shannon-greenlight/KiCAD/README.md

# Greenface KiCAD Libraries
The Greenface KiCAD libraries are required to use KiCAD with the Greenface designs.
KiCAD 8.0 or later is required.
* Place everything in a new folder named eg. GreenfaceKiCAD.
* For schematics, create a Project Specific Library eg. C:\Users\bill\Documents\GreenfaceKiCAD\greenface-symbols\greenface-symbols.kicad_sym
* Give this Library the Nickname: greenface
* For PCB, create a Project Specific Library eg. C:\Users\bill\Documents\GreenfaceKiCAD\panel.pretty
* Give this Library the Nickname: greenface
* For 3d Parts, create a Path called GREENFACE_KICAD_DIR with the value eg. C:\Users\bill\Documents\GreenfaceKiCAD
