shannon-greenlight/KiCAD/3d_Models/Sifam_Knob_Large_Short_Unskirted.step

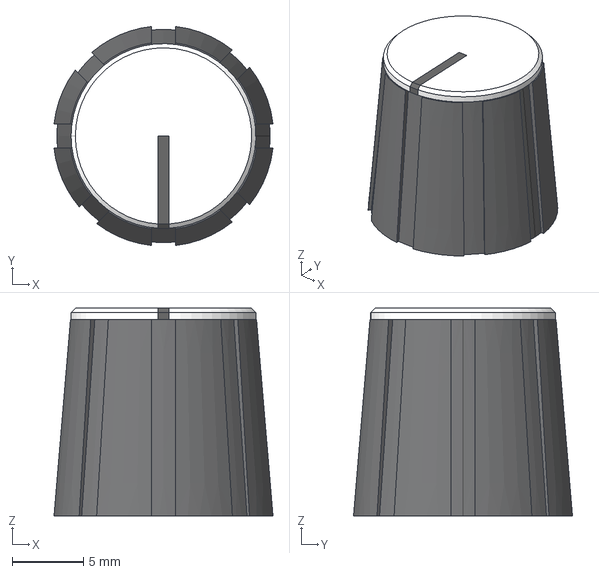
[picture p1: CAD file, 2024-02-22]
3d_Models/Sifam_Knob_Large_Short_Unskirted.step
15.4 x 15.4 x 14.6 mm
