shannon-greenlight/KiCAD/3d_Models/FreeCAD/Sifam_Knob_Parameterised.FCStd

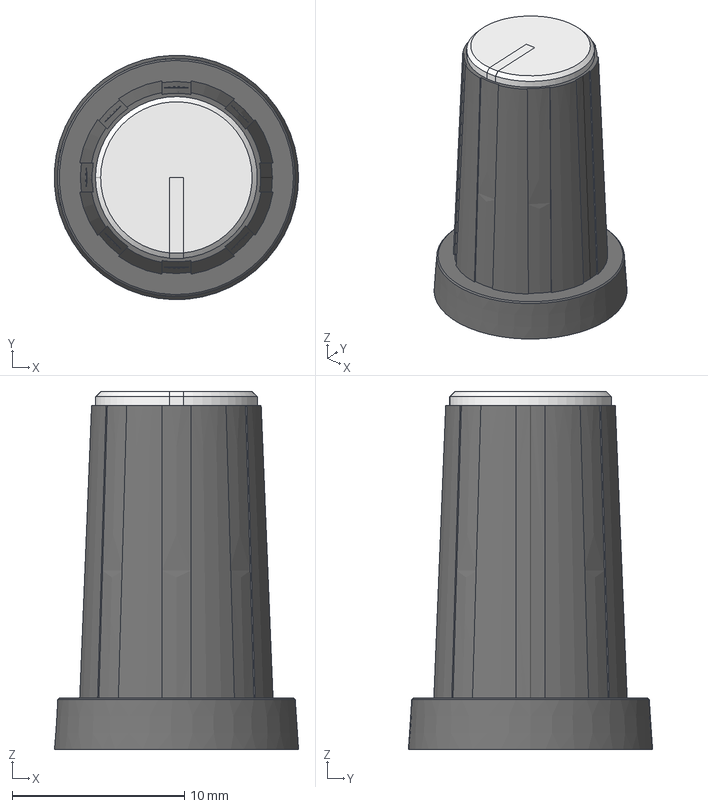
[picture p2: CAD file, 2024-02-22]
3d_Models/FreeCAD/Sifam_Knob_Parameterised.FCStd
14.2 x 14.2 x 20.8 mm
White_Cap_Chamfered
Black_Marker_Chamfered
Base
Ridged_Body
