shannon-greenlight/KiCAD/3d_Models/PTA4543-2010CPB103--3DModel-STEP-269445.STEP

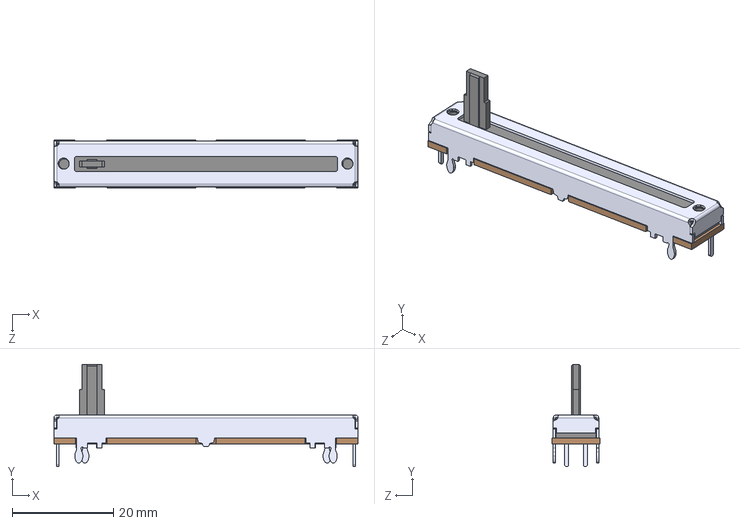
[picture p3: CAD file, 2024-02-22]
3d_Models/PTA4543-2010CPB103--3DModel-STEP-269445.STEP
60.0 x 20.2 x 9.40 mm
