shannon-greenlight/KiCAD/3d_Models/evqq2-bfkpuy-03w_.step

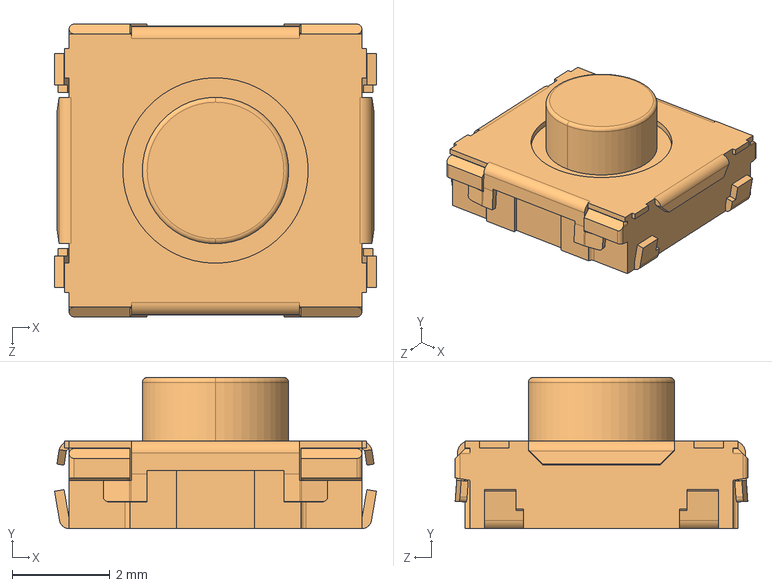
[picture p4: CAD file, 2024-02-22]
3d_Models/evqq2-bfkpuy-03w_.step
6.60 x 3.10 x 6.00 mm
