shannon-greenlight/KiCAD/3d_Models/FreeCAD/bu/knob.FCStd

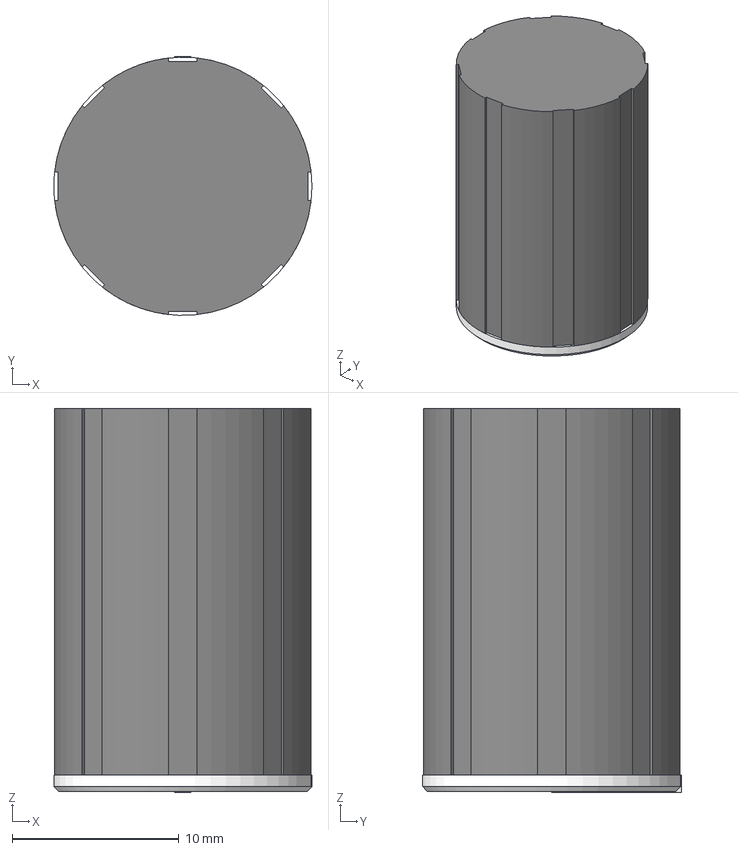
[picture p5: CAD file, 2024-02-22]
3d_Models/FreeCAD/bu/knob.FCStd
15.5 x 15.5 x 23.1 mm
Knob_Body
