shannon-greenlight/KiCAD/3d_Models/FreeCAD/bu/Sifam_Knob_Large_Tall_Unskirted.FCStd

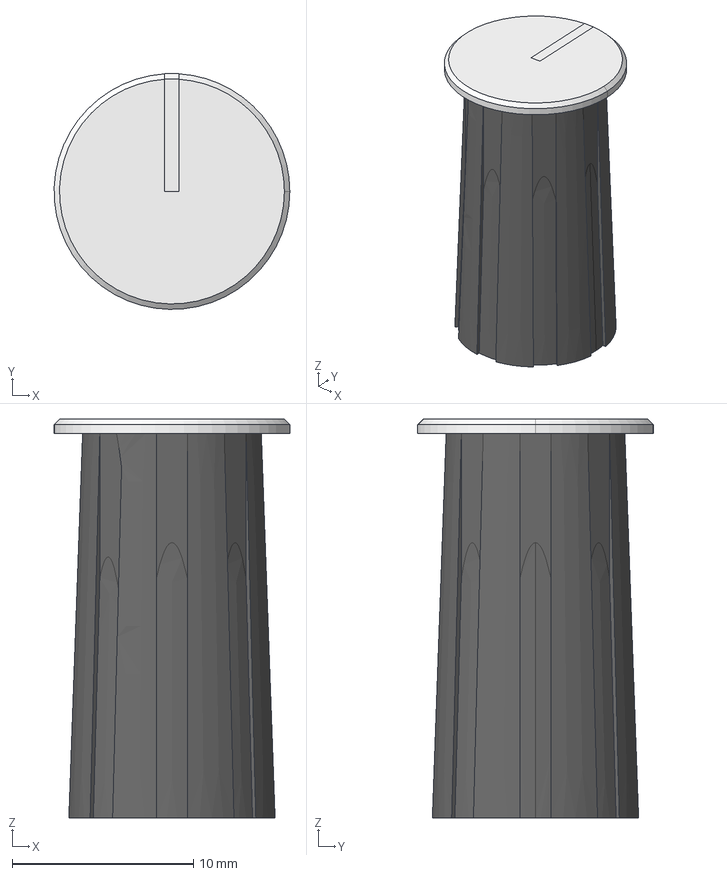
[picture p6: CAD file, 2024-02-22]
3d_Models/FreeCAD/bu/Sifam_Knob_Large_Tall_Unskirted.FCStd
13.0 x 13.0 x 22.0 mm
White_Cap_Chamfered
Black_Marker_Chamfered
Knob_Body_Ridged
