shannon-greenlight/KiCAD/3d_Models/RJ45 x 1.step

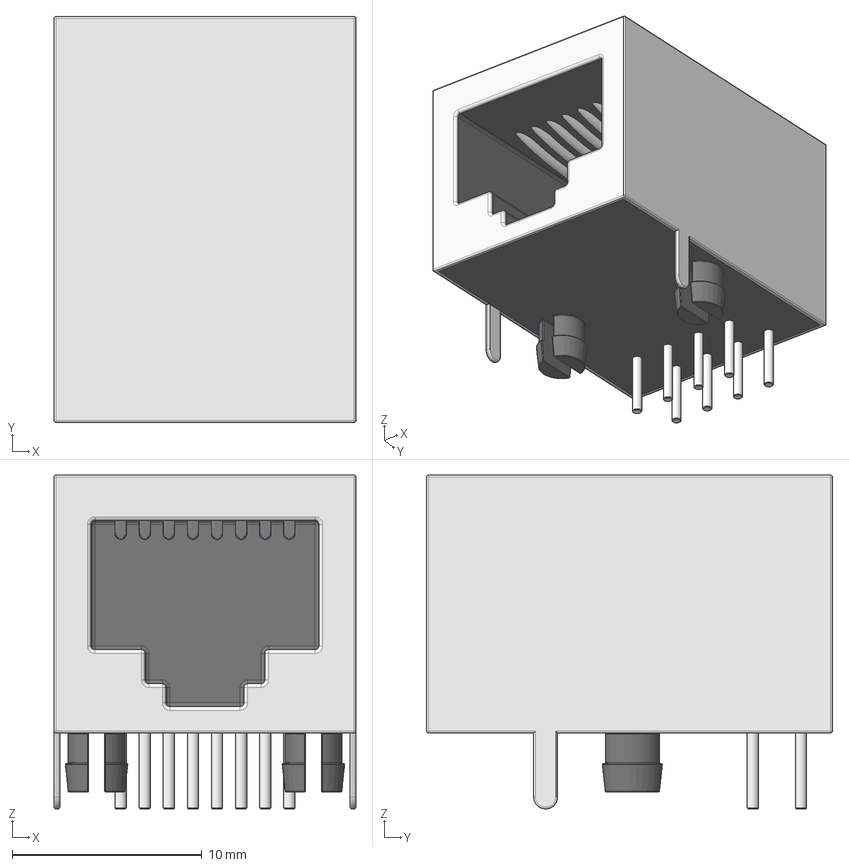
[picture p7: CAD file, 2024-02-22]
3d_Models/RJ45 x 1.step
15.9 x 21.4 x 17.6 mm
