shannon-greenlight/KiCAD/3d_Models/ALPHA-RD901F-40.step

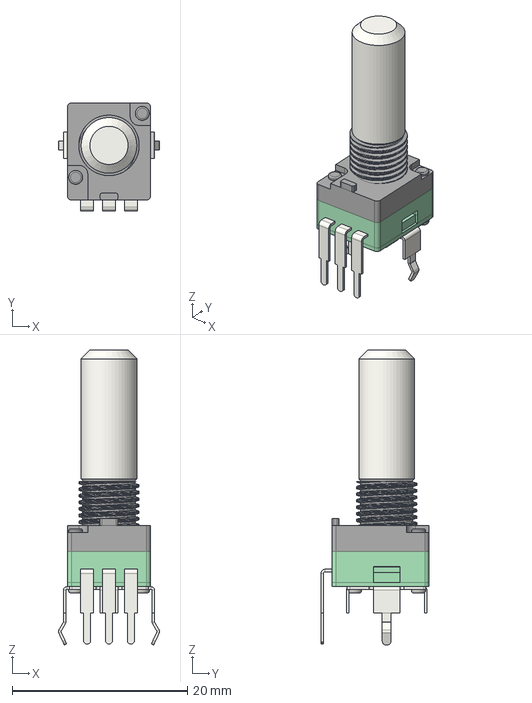
[picture p8: CAD file, 2024-02-22]
3d_Models/ALPHA-RD901F-40.step
11.5 x 12.4 x 33.6 mm
