shannon-greenlight/KiCAD/3d_Models/FreeCAD/bu/Sifam_Knob.FCStd

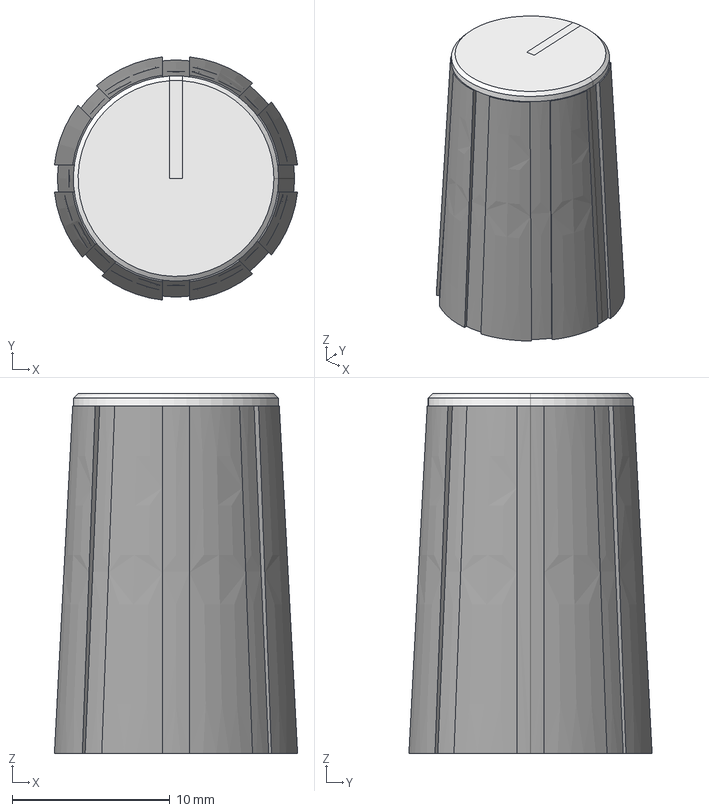
[picture p9: CAD file, 2024-02-22]
3d_Models/FreeCAD/bu/Sifam_Knob.FCStd
15.4 x 15.4 x 22.8 mm
Knob_Body_Ridged
White_Cap_Chamfered
Black_Marker_Chamfered
