shannon-greenlight/KiCAD/3d_Models/DX07S024WJ3R400--3DModel-STEP-56544.STEP

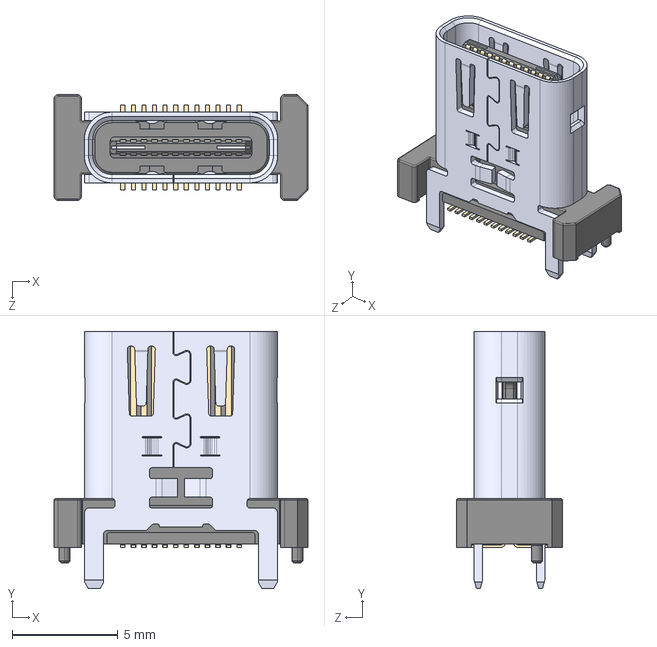
[picture p10: CAD file, 2024-02-22]
3d_Models/DX07S024WJ3R400--3DModel-STEP-56544.STEP
12.0 x 12.2 x 5.00 mm
