shannon-greenlight/KiCAD/3d_Models/smdcrystal.STEP

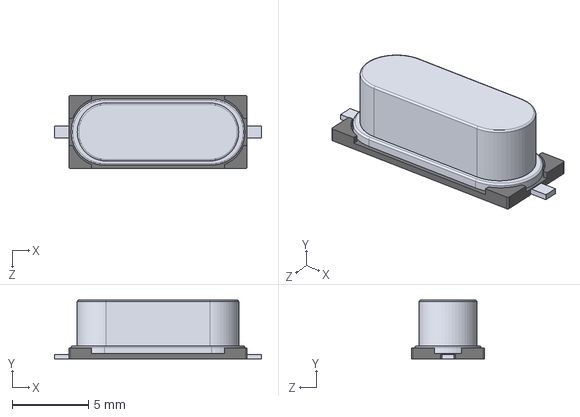
[picture p11: CAD file, 2024-02-22]
3d_Models/smdcrystal.STEP
13.6 x 3.85 x 4.80 mm
kalip
kristal
