shannon-greenlight/KiCAD/3d_Models/PJ301M-12 Thonkiconn v0.2.step

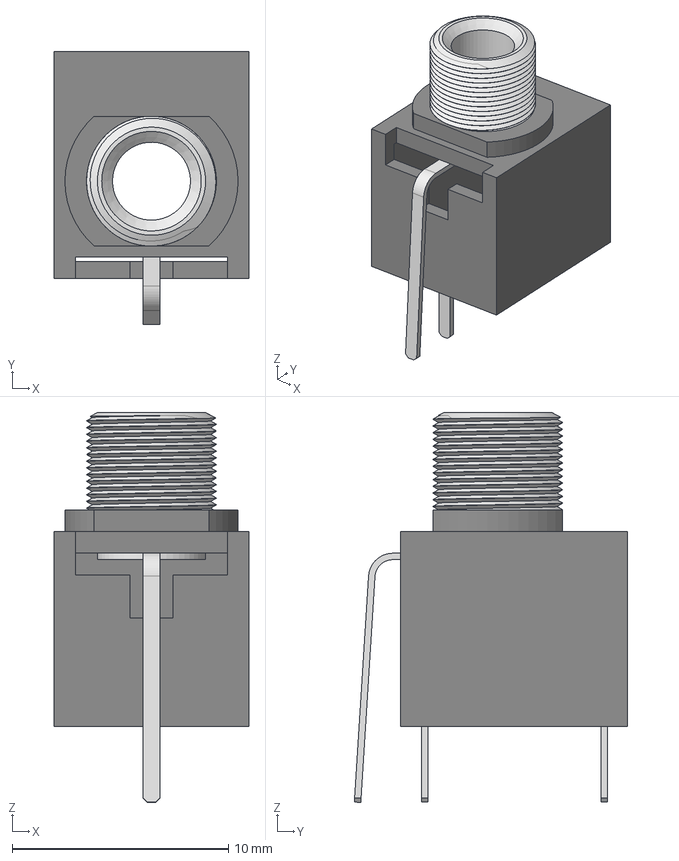
[picture p12: CAD file, 2024-02-22]
3d_Models/PJ301M-12 Thonkiconn v0.2.step
9.00 x 12.6 x 18.0 mm
