shannon-greenlight/KiCAD/3d_Models/100DP3T1B1M2QEH.step

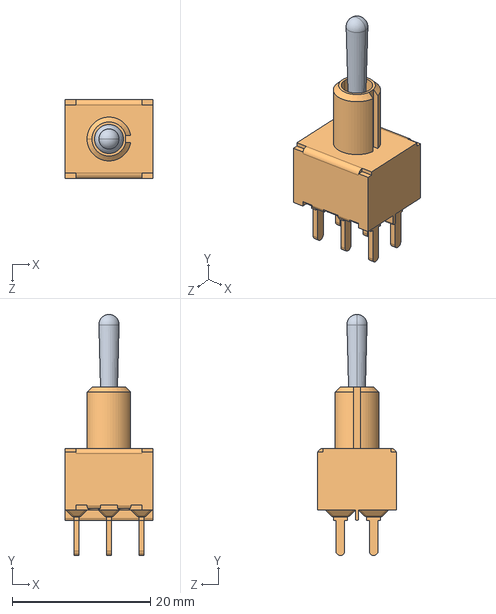
[picture p13: CAD file, 2024-02-22]
3d_Models/100DP3T1B1M2QEH.step
12.7 x 34.9 x 11.4 mm
