shannon-greenlight/KiCAD/3d_Models/Tall_Trimmer_Pot.step

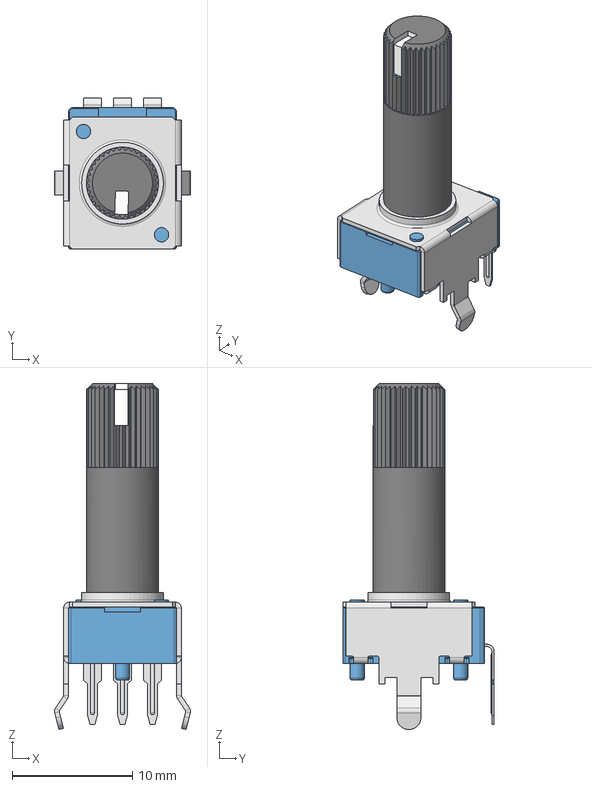
[picture p14: CAD file, 2024-02-22]
3d_Models/Tall_Trimmer_Pot.step
11.3 x 12.6 x 28.8 mm
