shannon-greenlight/KiCAD/3d_Models/PJ366ST.step

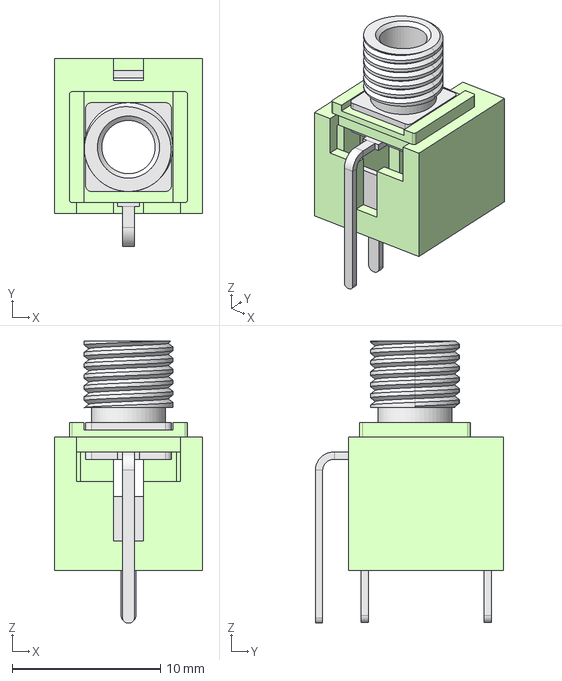
[picture p15: CAD file, 2024-02-22]
3d_Models/PJ366ST.step
10.0 x 12.7 x 19.1 mm
