shannon-greenlight/KiCAD/3d_Models/RJ45_Amphemol_RJHSE3080_c.step

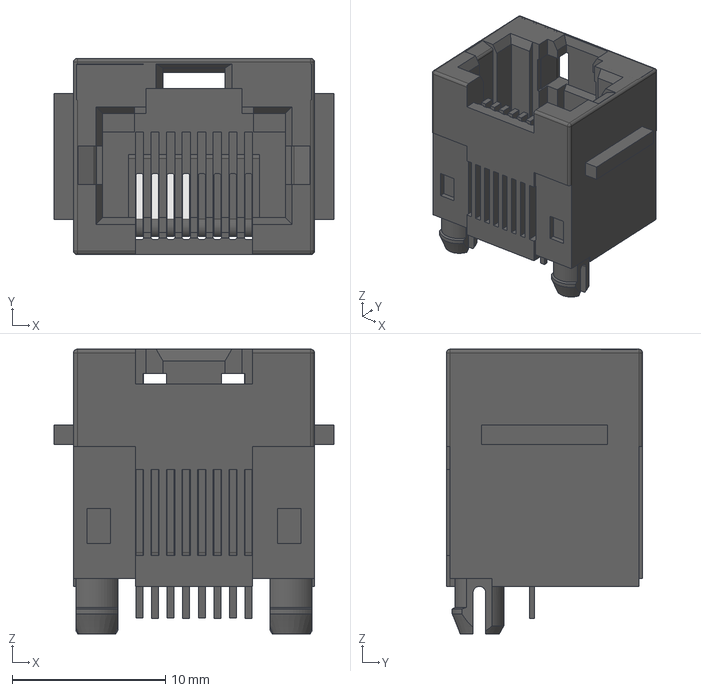
[picture p16: CAD file, 2024-02-22]
3d_Models/RJ45_Amphemol_RJHSE3080_c.step
18.3 x 12.8 x 18.6 mm
