shannon-greenlight/KiCAD/3d_Models/Toggle Switch Daily Well 1AS1T2B4M2QE.STEP

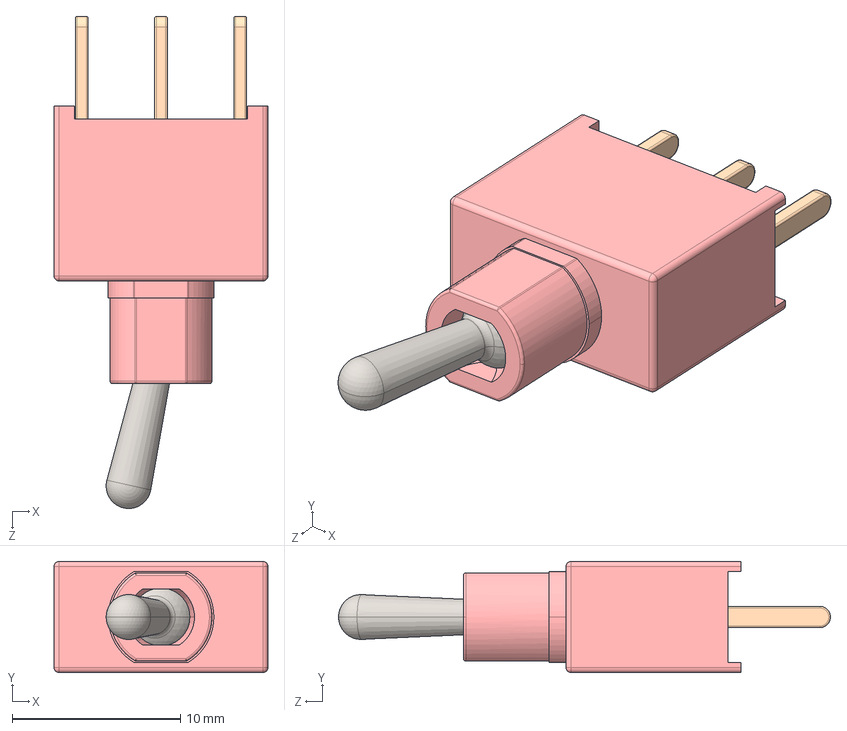
[picture p17: CAD file, 2024-02-22]
3d_Models/Toggle Switch Daily Well 1AS1T2B4M2QE.STEP
12.7 x 6.60 x 29.2 mm
