shannon-greenlight/KiCAD/3d_Models/USB_TE_1734517-1.step

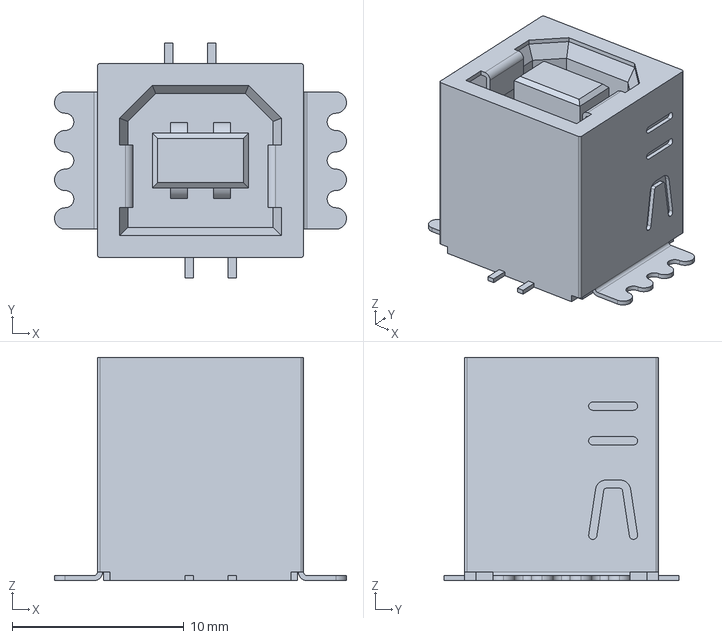
[picture p18: CAD file, 2024-02-22]
3d_Models/USB_TE_1734517-1.step
17.0 x 13.7 x 13.0 mm
