shannon-greenlight/KiCAD/3d_Models/Sifam_Knob_Small_Unskirted.step

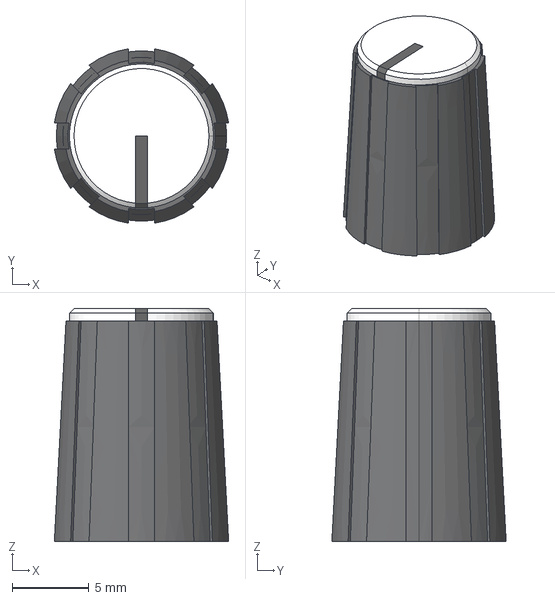
[picture p19: CAD file, 2024-02-22]
3d_Models/Sifam_Knob_Small_Unskirted.step
11.4 x 11.4 x 15.2 mm
