shannon-greenlight/KiCAD/3d_Models/Sifam_Knob_Large_Tall_Unskirted.step

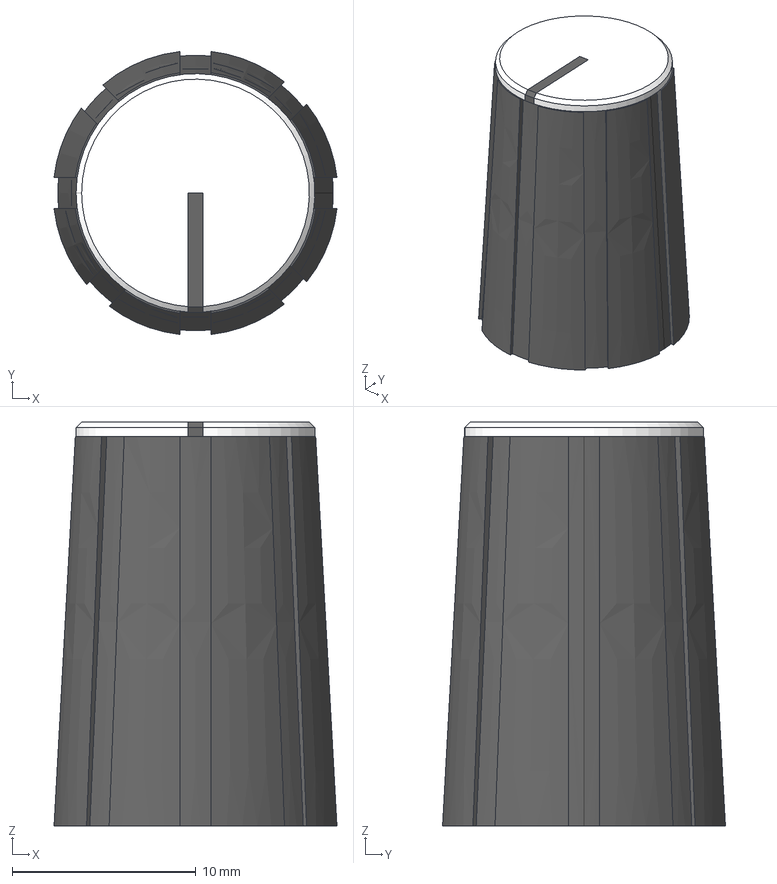
[picture p20: CAD file, 2024-02-22]
3d_Models/Sifam_Knob_Large_Tall_Unskirted.step
15.4 x 15.4 x 22.0 mm
