shannon-greenlight/KiCAD/3d_Models/EVQQ2-DHMSW2-02W.step

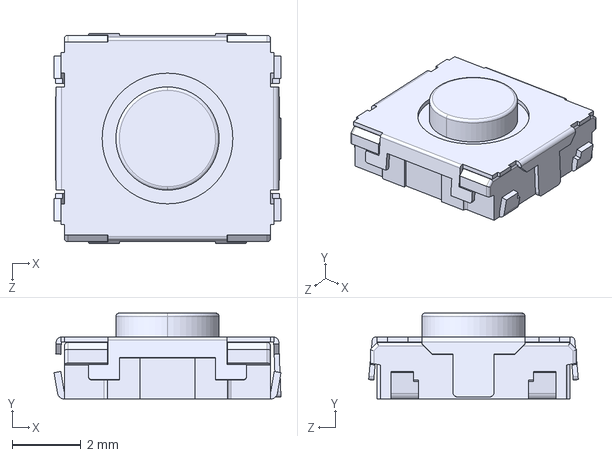
[picture p21: CAD file, 2024-02-22]
3d_Models/EVQQ2-DHMSW2-02W.step
6.60 x 2.50 x 6.10 mm
