shannon-greenlight/KiCAD/3d_Models/5_Pin_DIN.step

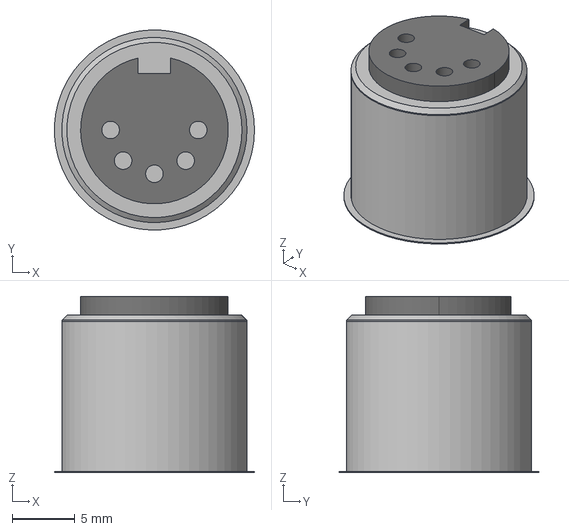
[picture p22: CAD file, 2024-02-22]
3d_Models/5_Pin_DIN.step
16.0 x 16.0 x 14.1 mm
