shannon-greenlight/KiCAD/3d_Models/SIFAM_Slider_Cap_black.stp

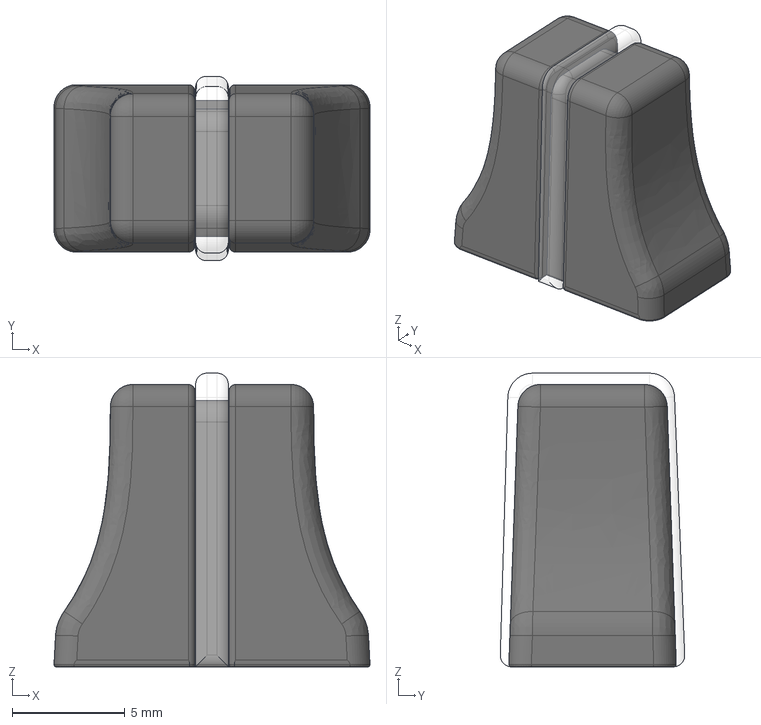
[picture p23: CAD file, 2024-02-22]
3d_Models/SIFAM_Slider_Cap_black.stp
14.0 x 8.16 x 13.0 mm
