shannon-greenlight/KiCAD/3d_Models/Sifam_Knob_Small_Skirted.step

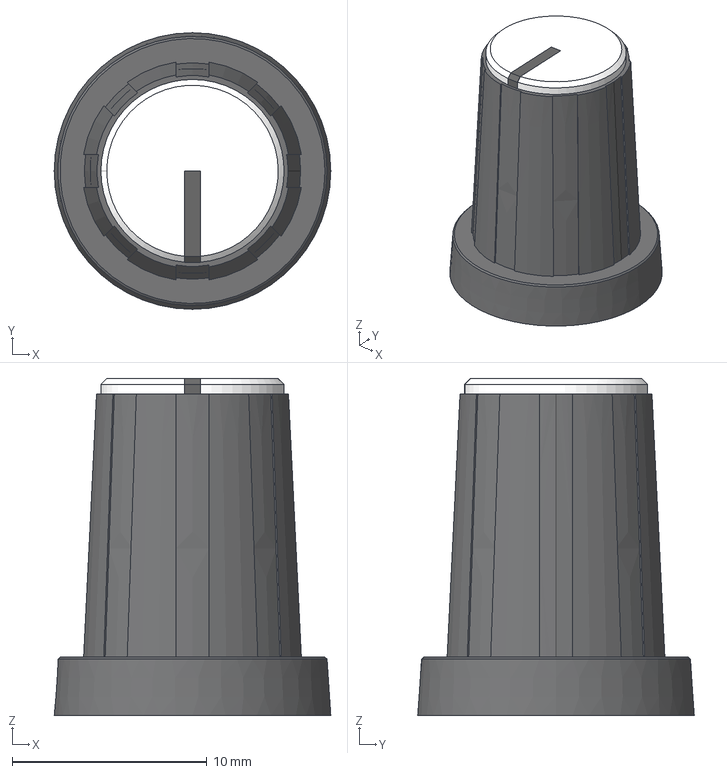
[picture p24: CAD file, 2024-02-22]
3d_Models/Sifam_Knob_Small_Skirted.step
14.2 x 14.2 x 17.3 mm
