shannon-greenlight/KiCAD/3d_Models/Micro_T18_Knob.step

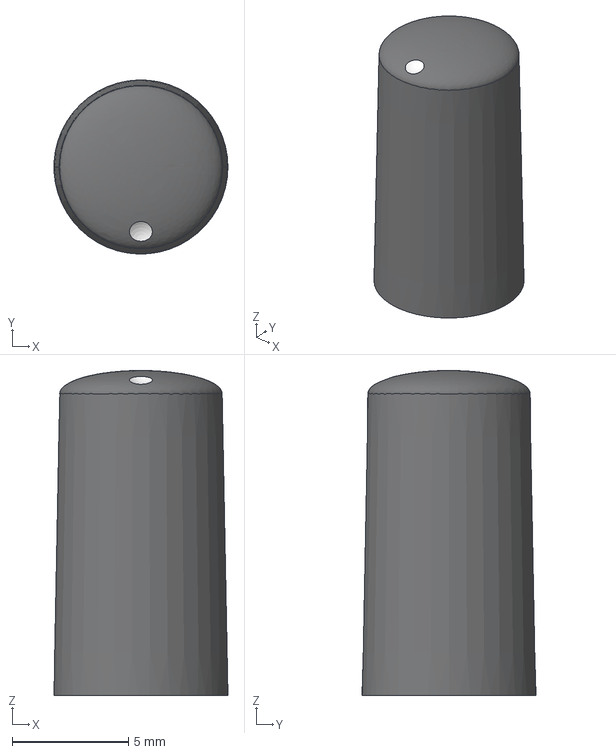
[picture p25: CAD file, 2024-02-22]
3d_Models/Micro_T18_Knob.step
7.49 x 7.50 x 14.0 mm
