shannon-greenlight/KiCAD/3d_Models/PJ302M.step

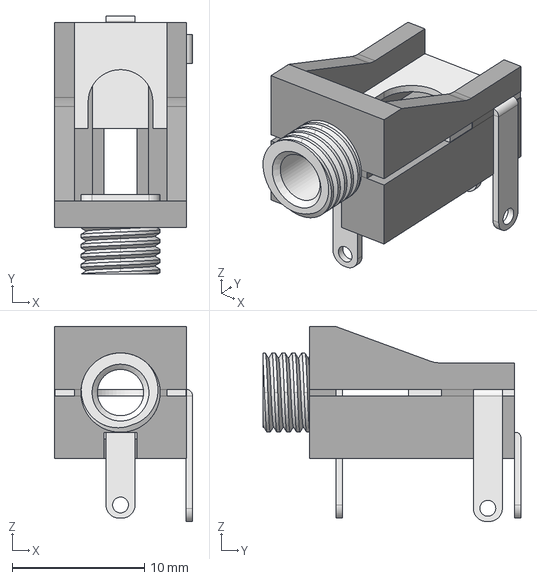
[picture p26: CAD file, 2024-02-22]
3d_Models/PJ302M.step
10.4 x 19.5 x 14.8 mm
