shannon-greenlight/KiCAD/3d_Models/USB_B_Micro.stp

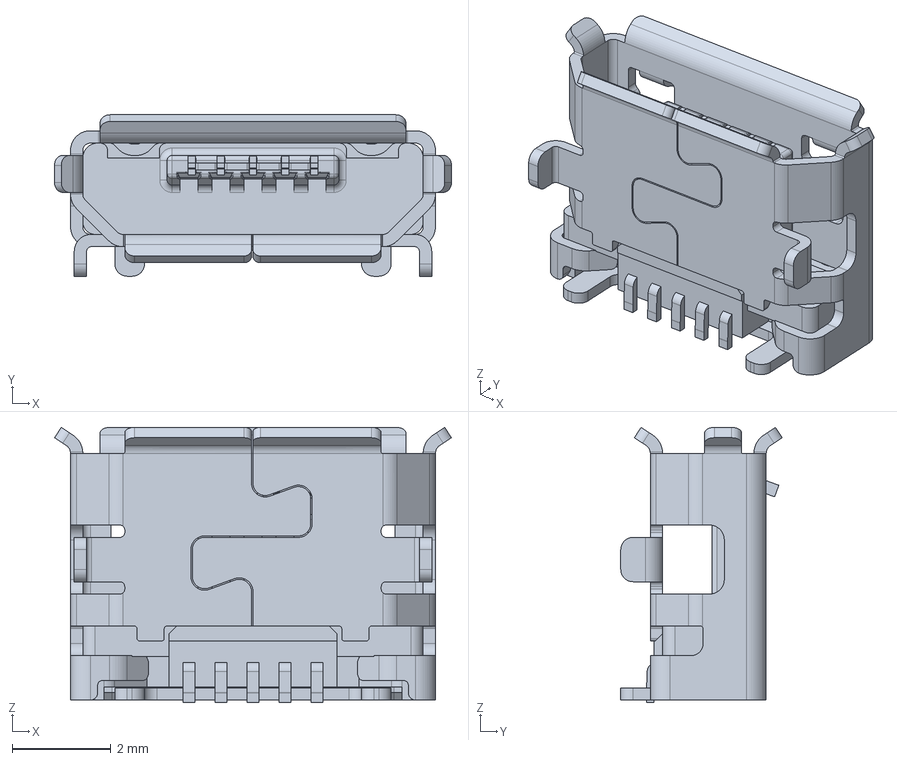
[picture p27: CAD file, 2024-02-22]
3d_Models/USB_B_Micro.stp
8.05 x 3.27 x 5.58 mm
