shannon-greenlight/KiCAD/3d_Models/Sifam_Knob_Small_Tall_Unskirted.step

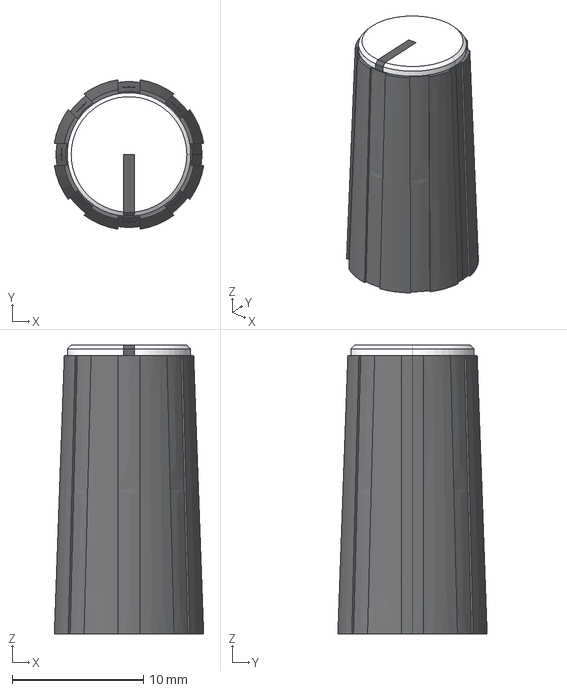
[picture p28: CAD file, 2024-02-22]
3d_Models/Sifam_Knob_Small_Tall_Unskirted.step
11.4 x 11.4 x 22.0 mm
