shannon-greenlight/KiCAD/3d_Models/TC33X-2-103E.STEP

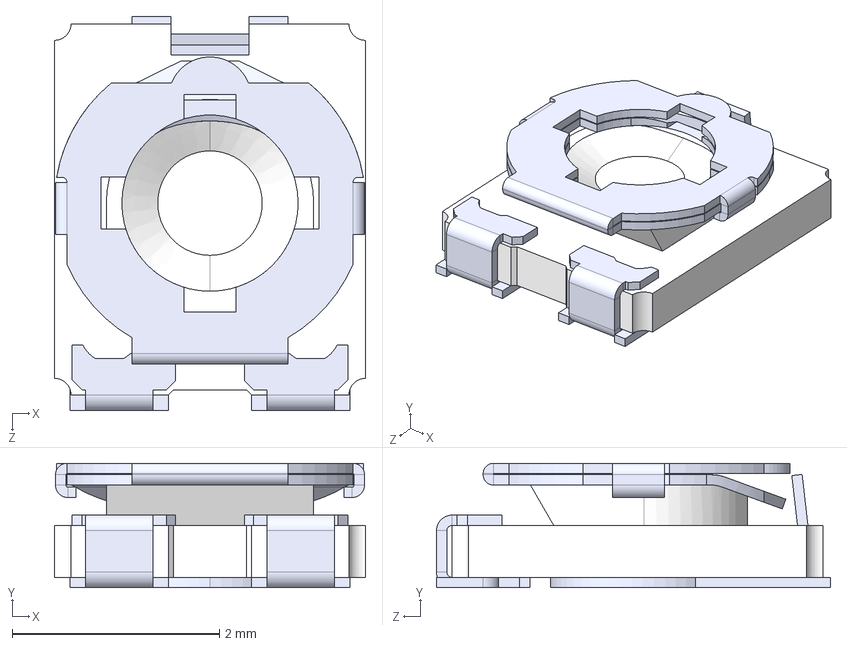
[picture p29: CAD file, 2024-02-22]
3d_Models/TC33X-2-103E.STEP
3.00 x 1.20 x 3.80 mm
