shannon-greenlight/KiCAD/3d_Models/PST-121A_IP67.STEP

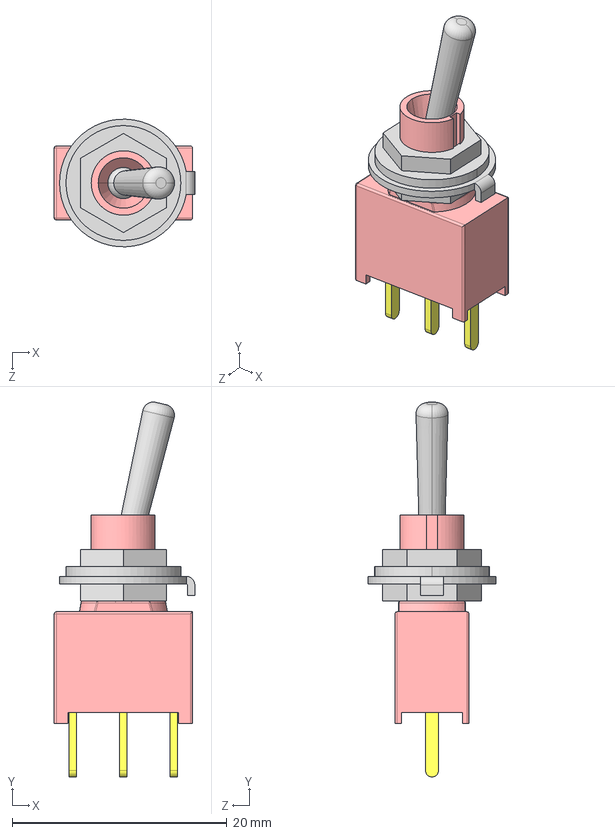
[picture p30: CAD file, 2024-02-22]
3d_Models/PST-121A_IP67.STEP
13.1 x 34.9 x 11.9 mm
