shannon-greenlight/KiCAD/3d_Models/pinhead_2x8_shrouded.step

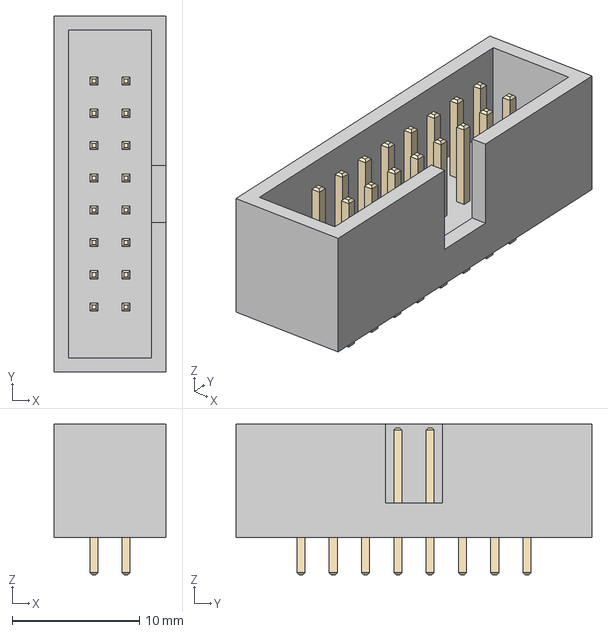
[picture p31: CAD file, 2024-02-22]
3d_Models/pinhead_2x8_shrouded.step
8.80 x 28.0 x 11.8 mm
