shannon-greenlight/KiCAD/(list of files, cad)

Other CAD files:
3d_Models/RJ45_Amphemol_RJHSE3080.step
3d_Models/c-1734517-1-b-3d.stp
3d_Models/Sifam_Knob_Large_Short_unksirted.step
3d_Models/12401951E412A--3DModel-STEP-533217.STEP
3d_Models/428788506.stp
3d_Models/6mm_Nut.step
3d_Models/FreeCAD/5_Pin_DIN.FCStd
3d_Models/FreeCAD/6mm_Nut.FCStd
3d_Models/FreeCAD/Micro_T18_Knob.FCStd
3d_Models/FreeCAD/Modified Nut.FCStd
3d_Models/FreeCAD/Sifam_Knob_Large_Short_Unskirted.FCStd
3d_Models/FreeCAD/Sifam_Knob_Large_Tall_Unskirted.FCStd
3d_Models/FreeCAD/Sifam_Knob_Small_Skirted.FCStd
3d_Models/FreeCAD/Sifam_Knob_Small_Tall_Unskirted.FCStd
3d_Models/FreeCAD/Sifam_Knob_Small_Unskirted.FCStd
3d_Models/FreeCAD/bu/Hex Nut SMA 14 36 UNS v8.step
3d_Models/FreeCAD/bu/SMA Nut 36UNS-2B.step
3d_Models/PJ302M_Hex_nut.step
3d_Models/PJ302M_Knurl_nut.step
3d_Models/PJ366ST_Hex_nut.step
3d_Models/PJ366ST_Knurl_nut.step
