shannon-greenlight/KiCAD/(commit log)

2022-11-27 Adds BOM python scripts
2022-12-19 Adds CUI power inverter
    CUI_VXO78-1000 added
2023-11-12 Adds footprints
2024-02-22 Adds some parts libraries and models.
    Updates kicad_netlist_reader.py to fix regex.
    [100DP3T1B1M2QEH.step, 12401951E412A--3DModel-STEP-533217.STEP, 428788506.stp, 5_Pin_DIN.FCStd, 5_Pin_DIN.step, 6mm_Nut.FCStd, 6mm_Nut.step, ALPHA-RD901F-40.step]
2024-04-22 Adds Other component source to BOM
2024-04-22 Adds new Mult switch EG1248
    Adds temp 3d model that isn't accurate. Good for ltesting.
2025-01-22 Archive cleanup.
    [472570001.stp]
2025-01-22 Adds SparkFun-Switch-symbols
2025-07-09 Adds 3d_Models,etc.
    Updates some greenface footprints.
    Adds bom2grouped.xsl
    [100DP3T1B1M2QEH.step, 12401951E412A--3DModel-STEP-533217.STEP, 428788506.stp, 5_Pin_DIN.FCStd, 5_Pin_DIN.step, 6mm_Nut.FCStd, 6mm_Nut.step, ALPHA-RD901F-40.step]
